JONeillSr/RFID_Access/hardware/RFID_Door_Controller/board_top.png

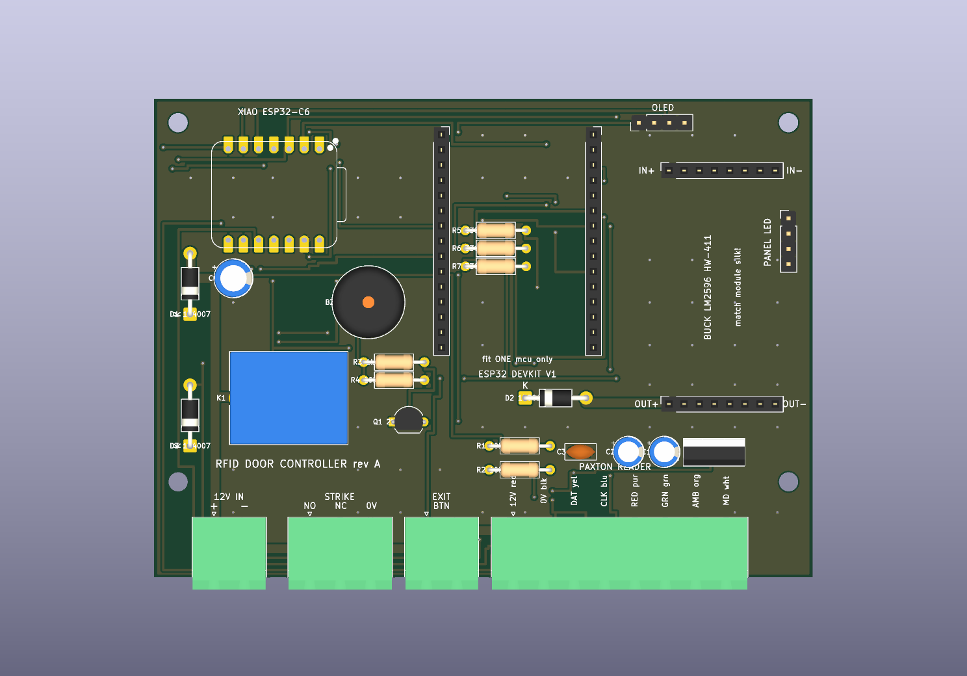
hardware/RFID_Door_Controller/board_top.png
