JONeillSr/RFID_Access/hardware/RFID_Door_Controller/RFID_Door_Controller.step

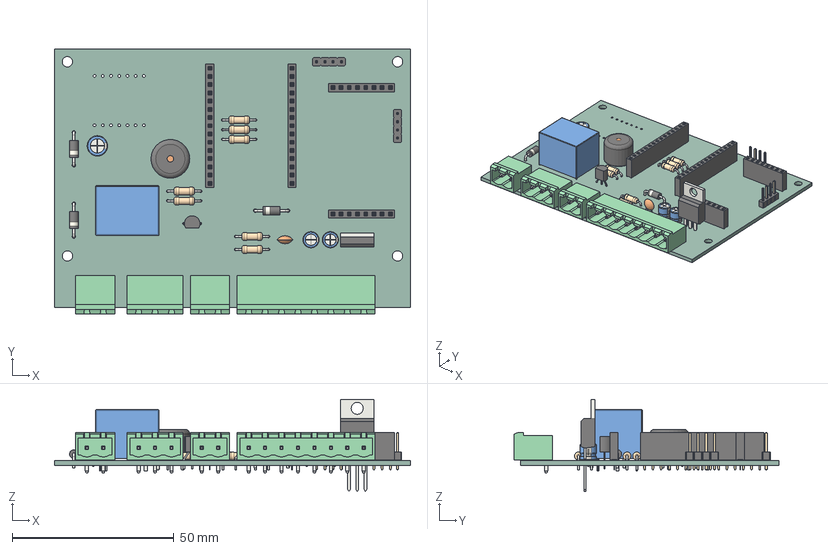
[picture p2: CAD file, 2026-08-13]
hardware/RFID_Door_Controller/RFID_Door_Controller.step
110.0 x 82.0 x 28.5 mm
PhoenixContact_MSTBA_2,5_2-G-5,08_1x02_P5.08mm_Horizontal x 2
PinSocket_1x08_P2.54mm_Vertical x 2
PinHeader_1x04_P2.54mm_Vertical x 2
R_Axial_DIN0207_L6.3mm_D2.5mm_P10.16mm_Horizontal x 7
D_DO-41_SOD81_P10.16mm_Horizontal x 3
PhoenixContact_MSTBA_2,5_8-G-5,08_1x08_P5.08mm_Horizontal
TO-220-3_Vertical
PhoenixContact_MSTBA_2,5_3-G-5,08_1x03_P5.08mm_Horizontal
CP_Radial_D6.3mm_P2.50mm
C_Disc_D5.0mm_W2.5mm_P2.50mm
TO-92_Inline_Wide
Buzzer_12x9.5RM7.6
Relay_SPDT_SANYOU_SRD_Series_Form_C
CP_Radial_D5.0mm_P2.50mm x 2
PinSocket_1x15_P2.54mm_Vertical x 2
RFID_Door_Controller_PCB
