JONeillSr/RFID_Access/hardware/RFID_Door_Controller/assembly_silk_guide.png

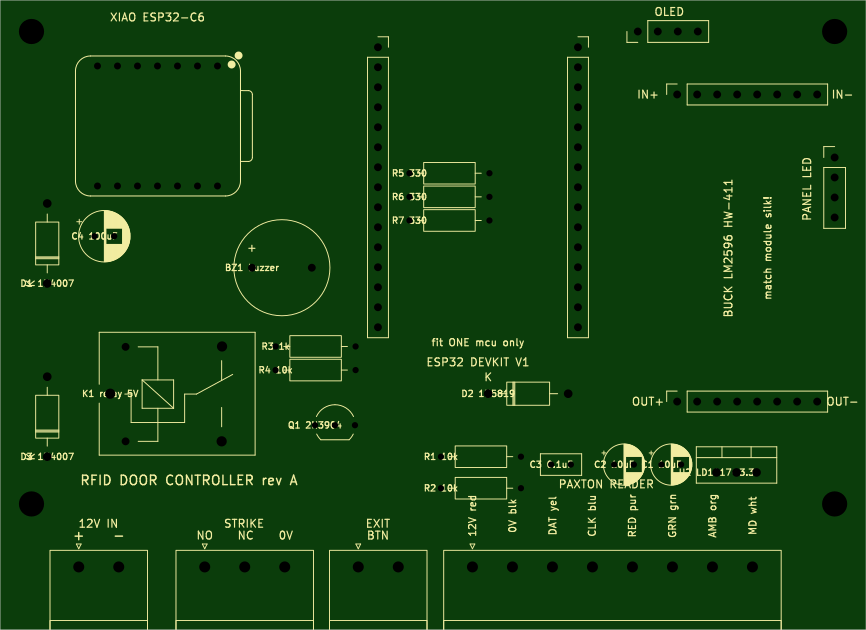
hardware/RFID_Door_Controller/assembly_silk_guide.png
