JONeillSr/RFID_Access/schematic.pdf

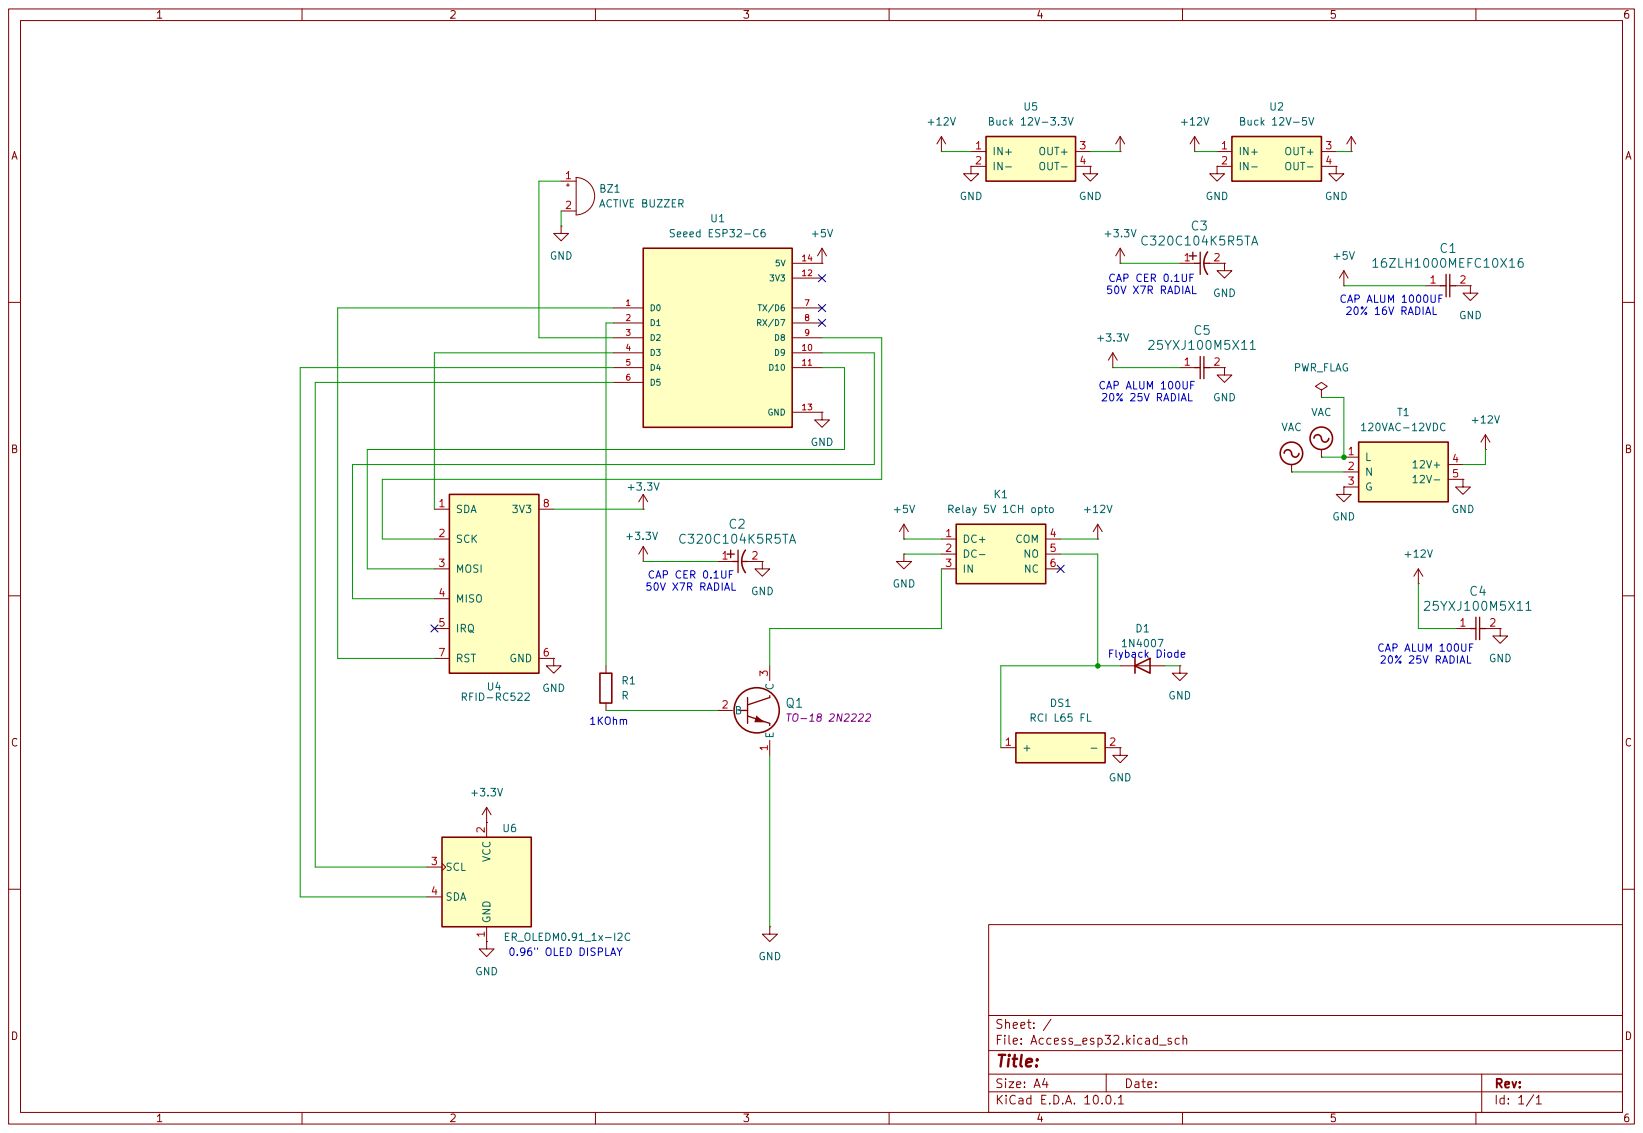
[picture p4: page 1]
