JONeillSr/RFID_Access/hardware/RFID_Door_Controller/RFID_Door_Controller.kicad_pcb

## KiCad design hardware/RFID_Door_Controller/RFID_Door_Controller.kicad_pcb (2026-08-13)

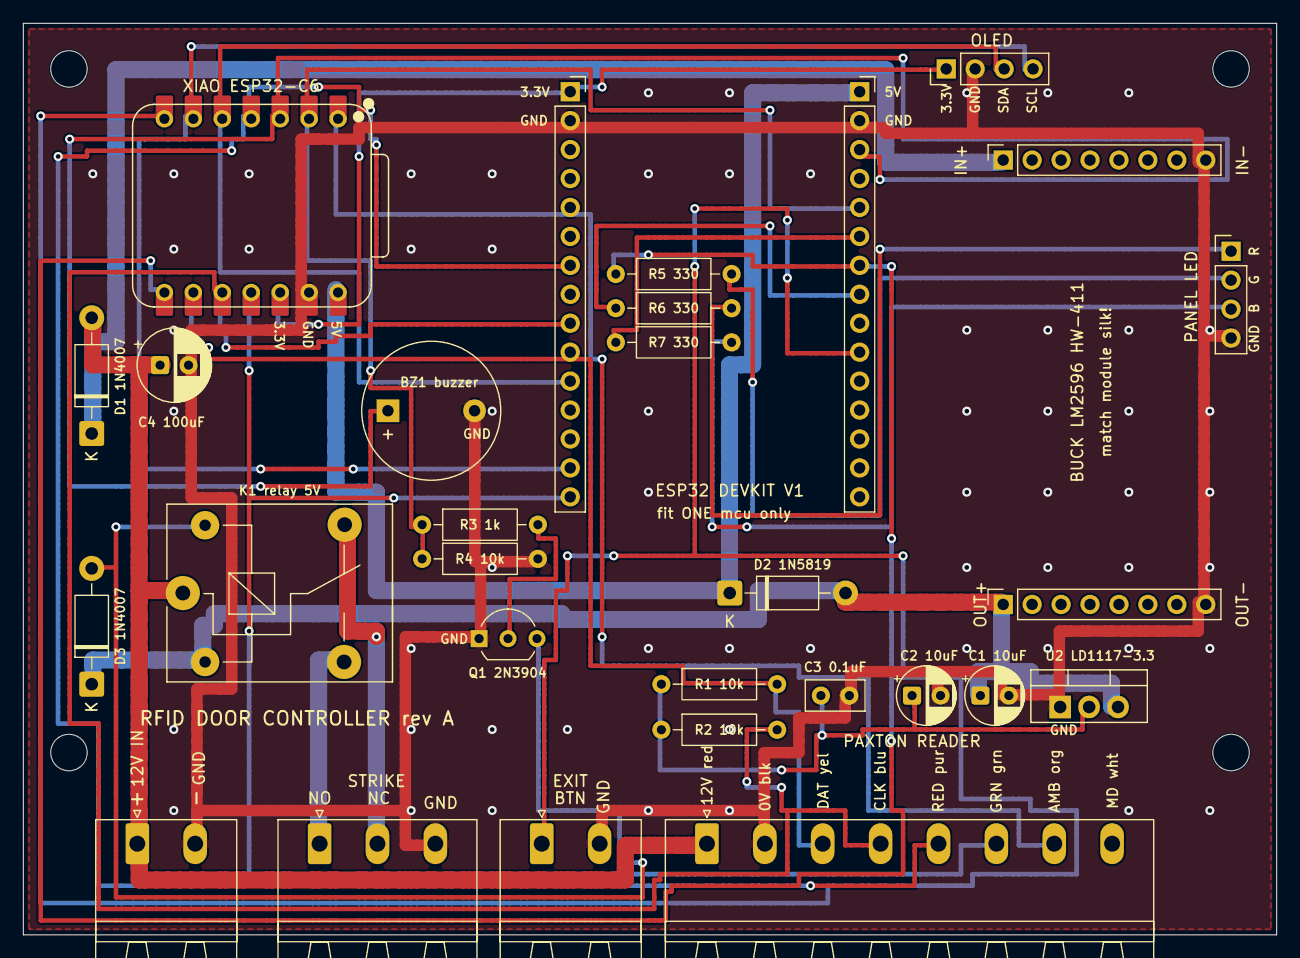
[picture p5: board RFID_Door_Controller.kicad_pcb from above]

Board: 2 copper layers, 110.0 x 80.0 mm, 33 parts (0 on the bottom side), 27 nets.

Parts:
BZ1: Buzzer_12x9.5RM7.6
C1, C2: 10u; CP_Radial_D5.0mm_P2.50mm
C3: 100n; C_Disc_D5.0mm_W2.5mm_P2.50mm
C4: 100u; CP_Radial_D6.3mm_P2.50mm
D1, D3: 1N4007; D_DO-41_SOD81_P10.16mm_Horizontal
D2: 1N5819; D_DO-41_SOD81_P10.16mm_Horizontal
H1, H2, H3, H4: MountingHole_3.2mm_M3
J1, J5: PhoenixContact_MSTBA_2,5_2-G-5,08_1x02_P5.08mm_Ho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; PhoenixContact_MSTBA_2,5_2-G-5,08_1x02_P5.08mm_Horizontal
J2, J10: PinSocket_1x08_P2.54mm_Vertical
J3: PhoenixContact_MSTBA_2,5_8-G-5,08_1x08_P5.08mm_Ho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; PhoenixContact_MSTBA_2,5_8-G-5,08_1x08_P5.08mm_Horizontal
J4: PhoenixContact_MSTBA_2,5_3-G-5,08_1x03_P5.08mm_Ho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; PhoenixContact_MSTBA_2,5_3-G-5,08_1x03_P5.08mm_Horizontal
J6, J7: PinHeader_1x04_P2.54mm_Vertical
J8, J9: PinSocket_1x15_P2.54mm_Vertical
K1: SRD-05VDC-SL-C; Relay_SPDT_SANYOU_SRD_Series_Form_C
Q1: 2N3904; TO-92_Inline_Wide
R1, R2, R4: 10k; R_Axial_DIN0207_L6.3mm_D2.5mm_P10.16mm_Horizontal
R3: 1k; R_Axial_DIN0207_L6.3mm_D2.5mm_P10.16mm_Horizontal
R5, R6, R7: 330; R_Axial_DIN0207_L6.3mm_D2.5mm_P10.16mm_Horizontal
U1: XIAO-ESP32-C6-DIP
U2: LD1117V33; TO-220-3_Vertical

Connections:
3V3_MCU: J6.1, J8.1, U1.12
3V3_PU: C2.1, C3.1, R1.1, R2.1, U2.2
5V: C1.1, D2.2, D3.1, J10.1, K1.2, U2.3
5V_MCU: D2.1, J9.1, U1.14
12V_PROT: D1.1, J2.1
12V_RAW: C4.1, D1.2, J1.1, J3.1, K1.1
AMBER_LED: J3.7, J8.5, U1.1
BUZZER: BZ1.1, J9.3, U1.3
CLOCK: J3.4, J8.9, R2.2, U1.10
COIL_SW: D3.2, K1.5, Q1.3
DATA: J3.3, J8.10, R1.2, U1.9
EXIT_BTN: J5.1, J9.10, U1.7
GND: BZ1.2, C1.2, C2.2, C3.2, C4.2, J1.2, J2.8, J3.2, J4.3, J5.2, J6.2, J7.4, J8.2, J9.2, J10.8, Q1.1, R4.2, U1.13, U2.1
GREEN_LED: J3.6, J8.15, U1.11
PANEL_B: J9.6, R7.1
PANEL_B_J: J7.3, R7.2
PANEL_G: J9.7, R5.1, U1.8
PANEL_G_J: J7.2, R5.2
PANEL_R: J9.8, R6.1
PANEL_R_J: J7.1, R6.2
Q1_B: Q1.2, R3.2
RED_LED: J3.5, J8.7, U1.4
RELAY_CTL: J9.5, R3.1, R4.1, U1.2
SCL: J6.4, J8.14, U1.6
SDA: J6.3, J8.11, U1.5
STRIKE_NC: J4.2, K1.4
STRIKE_NO: J4.1, K1.3
