JONeillSr/RFID_Access/src/JTLogoBitmap.h

#pragma once
#include <Arduino.h>

/**
 * @file    JTLogoBitmap.h
 * @brief   The JT Custom Trailers boot-logo bitmap (project-specific data).
 *
 * Kept separate from the generic SplashScreen library so the animator stays
 * logo-agnostic. Pass these to SplashScreen:
 *   SplashScreen splash(display, JT_LOGO, JT_LOGO_W, JT_LOGO_H, JT_LOGO_REST_Y);
 *
 * The bitmap is 1-bit, Adafruit_GFX drawBitmap format.
 */

static const uint16_t JT_LOGO_W = 128;
static const uint16_t JT_LOGO_H = 33;
// Rest near the top so it sits in the blue zone of a 2-color OLED (matches the
// original splash placement). Use -1 with SplashScreen for vertical centering.
static const int16_t  JT_LOGO_REST_Y = 17;

static const unsigned char JT_LOGO[] PROGMEM = {
  0x00, 0x00, 0x00, 0x00, 0x00, 0x00, 0x00, 0x00, 0x00, 0x00, 0x00, 0x00,
  0x00, 0x03, 0x83, 0xC0, 0x00, 0x00, 0x00, 0x00, 0x00, 0x00, 0x00, 0x00,
  0x00, 0x00, 0x00, 0x78, 0x7F, 0x0F, 0x87, 0xC0, 0x00, 0x00, 0x00, 0x00,
  0x00, 0x00, 0x00, 0x00, 0x1C, 0x3F, 0xBF, 0xF9, 0xFF, 0x9F, 0x8F, 0xC0,
  0x00, 0x00, 0x00, 0x00, 0x00, 0x00, 0x3F, 0x9E, 0x3C, 0xFF, 0xBF, 0xFB,
  0xFF, 0x9F, 0x8F, 0xC0, 0x00, 0x00, 0x00, 0x00, 0x00, 0x18, 0xFF, 0xBE,
  0x3D, 0xFF, 0x7F, 0xF7, 0xC7, 0xDF, 0xDF, 0x80, 0x00, 0x00, 0x00, 0x1F,
  0xFF, 0xF9, 0xFF, 0xBC, 0x3D, 0xE0, 0x07, 0x87, 0x87, 0xDF, 0xDF, 0x80,
  0x00, 0x07, 0xFF, 0xFF, 0xFF, 0xFB, 0xE0, 0x3C, 0x3D, 0xE0, 0x07, 0x0F,
  0x07, 0x9F, 0xFF, 0x80, 0x00, 0x0F, 0xFF, 0xFF, 0xFF, 0xF3, 0xC0, 0x3C,
  0x79, 0xFE, 0x0F, 0x0F, 0x07, 0xBD, 0xF7, 0x80, 0x00, 0x1F, 0xFF, 0xFF,
  0xFF, 0xF3, 0xC0, 0x7C, 0x79, 0xFF, 0x0F, 0x0F, 0x07, 0xBD, 0xF7, 0x80,
  0x00, 0x1F, 0xFF, 0xFF, 0xFF, 0xF7, 0x80, 0x7C, 0x78, 0x3F, 0x0F, 0x0F,
  0x0F, 0x3D, 0xE7, 0x00, 0x00, 0x1F, 0xFF, 0xFF, 0xFF, 0xE7, 0x80, 0x7C,
  0x78, 0x0F, 0x0F, 0x0F, 0xFE, 0x3C, 0xCF, 0x00, 0x00, 0x1F, 0xFF, 0xFF,
  0xFF, 0xE7, 0x80, 0x7C, 0xF3, 0xFF, 0x1E, 0x0F, 0xFC, 0x78, 0x0F, 0x00,
  0x00, 0x3F, 0xFF, 0xFF, 0xFC, 0x07, 0xFE, 0x7F, 0xF7, 0xFE, 0x1E, 0x07,
  0xF8, 0x78, 0x00, 0x00, 0x00, 0x3F, 0xFC, 0x0F, 0xF8, 0x03, 0xFE, 0x3F,
  0xE7, 0xFC, 0x1E, 0x00, 0x00, 0x00, 0x00, 0x3E, 0x00, 0x0F, 0xF8, 0x0F,
  0xF8, 0x01, 0xFE, 0x1F, 0x83, 0xE0, 0x00, 0x00, 0x00, 0x1F, 0xE0, 0xFF,
  0x00, 0x0F, 0xF8, 0x0F, 0xF8, 0x00, 0xF0, 0x00, 0x00, 0x00, 0x06, 0x01,
  0xFF, 0x3F, 0xF3, 0xFF, 0x00, 0x0F, 0xF0, 0x1F, 0xF0, 0x00, 0x00, 0x00,
  0x07, 0x03, 0xDF, 0x03, 0xFF, 0x3F, 0xFB, 0xE2, 0x00, 0x0F, 0xF0, 0x1F,
  0xF0, 0x3F, 0xE7, 0xFC, 0x0F, 0x83, 0x9E, 0x03, 0xFF, 0x3C, 0xFB, 0xC0,
  0x00, 0x1F, 0xF0, 0x1F, 0xF0, 0xFF, 0xEF, 0xFE, 0x1F, 0x87, 0x9E, 0x03,
  0xC0, 0x78, 0x7B, 0xF8, 0x00, 0x1F, 0xE0, 0x1F, 0xF0, 0xFF, 0xEF, 0xFE,
  0x1F, 0x87, 0x9E, 0x07, 0xFC, 0x78, 0xF3, 0xFE, 0x00, 0x1F, 0xE0, 0x3F,
  0xE0, 0xFF, 0x0F, 0x1E, 0x3F, 0x87, 0x9E, 0x07, 0xFC, 0x7F, 0xE1, 0xFE,
  0x00, 0x1F, 0xE0, 0x3F, 0xE0, 0x1E, 0x1E, 0x1E, 0x7B, 0x87, 0xBC, 0x07,
  0xFC, 0x7F, 0xC0, 0x1E, 0x00, 0x3F, 0xC0, 0x3F, 0xE0, 0x1E, 0x1F, 0xFC,
  0x73, 0xCF, 0x3C, 0x07, 0x80, 0xFF, 0xC0, 0x3E, 0x00, 0x3F, 0xC0, 0x7F,
  0xE0, 0x1C, 0x1F, 0xF8, 0xF7, 0xCF, 0x3C, 0x0F, 0x00, 0xF3, 0xC7, 0xFC,
  0x7C, 0x3F, 0xC0, 0x7F, 0xC0, 0x3C, 0x1F, 0xF0, 0xFF, 0xCF, 0x3F, 0xEF,
  0xFE, 0xF3, 0xCF, 0xF8, 0xFC, 0x7F, 0x80, 0x7F, 0xC0, 0x3C, 0x3F, 0xF1,
  0xFF, 0xCF, 0x7F, 0xEF, 0xFC, 0xF3, 0xE7, 0xE0, 0xFC, 0x7F, 0x80, 0x7F,
  0xC0, 0x3C, 0x3C, 0xF3, 0xE3, 0xDE, 0x7F, 0xEF, 0xFC, 0xE0, 0x00, 0x00,
  0xFF, 0xFF, 0x00, 0xFF, 0x80, 0x38, 0x3C, 0xFB, 0xC3, 0xDE, 0x7F, 0x00,
  0x00, 0x00, 0x00, 0x00, 0xFF, 0xFF, 0x00, 0xFF, 0x80, 0x78, 0x3C, 0x7F,
  0x80, 0x00, 0x00, 0x00, 0x00, 0x00, 0x00, 0x00, 0xFF, 0xFE, 0x00, 0xFF,
  0x80, 0x78, 0x00, 0x00, 0x00, 0x00, 0x00, 0x00, 0x00, 0x00, 0x00, 0x00,
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
};
