JONeillSr/RFID_Access/(commit log)

2026-08-13 Add board NVS backup
2026-08-15 Update to 2.1.0
    [partitions_rfid.csv]
2026-08-16 Fix packaging that deployed zero functions and took the fleet offline
    Compress-Archive produces a zip that is valid on Windows and unusable on the
    Linux Functions host, in two ways:
    - almost no directory entries -- 65 for this tree, and not the one holding
    the functions
    - external_attr = 0, i.e. Unix mode 000, so no file is readable
    Flex Consumption mounts the zip rather than extracting it, so both survive to
    runtime. A glob has to enumerate directories and stat files and can do neither:
    Worker was unable to load entry point "dist/api/src/functions/*.js":
    Found zero files matching the supplied pattern
    The host then registers zero functions and every route 404s -- includin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
2026-08-16 Roadmap: Phase 5 write side done, heap TODO, offline test log
    Phase 5 is now read and write. The on-device read-only lockout is the next
    piece: it was blocked on the write UI existing, since enforcing it earlier
    would have left paired doors unadministrable.
    Adds a TODO to expose free heap on /status, with minimum-free-since-boot.
    Found during the offline test: six hours of failed syncs are observable in
    every respect except the one that would reveal a leak, and repeated failed TLS
    handshakes are where a leak is most likely. The boot counter only catches a
    leak large enough to be fatal inside the window; a slower one looks like a
    healthy run and kills a door weeks later in the field. CloudSy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
2026-08-16 Require Admin to delete a credential
    The API allowed Operators to delete credentials while the documented role model
    and the admin UI both said Admin. The API was the permissive one, so the button
    being hidden was the only thing stopping it -- and hiding a button is a
    courtesy, not a control.
    Settled in favour of Admin, because deactivate and delete are not variations of
    the same action:
    deactivated future taps still name the holder -- "Carl - DENIED" at 2am
    deleted the same tap resolves to nobody, lands in the unknown-card feed,
    and is offered up for enrolment
    credentialIndex() resolves events against every credential regardless of
    `active`, which is what makes t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
2026-08-17 Pre-commit and commit-msg hooks: block card numbers
    The gitignore rules keep seed.json and *-fobs.json out of the repo and they work
    -- but they protect known FILES. A number pasted into source as a placeholder
    walks straight past them, into a public repo, in a file nobody would think to
    check. That is not hypothetical: a real enrolled card number was used as the
    placeholder in the fob form and reached a commit here earlier today.
    Two rules, calibrated against the whole tracked tree before shipping rather than
    tuned afterwards:
    A. a zero-padded run of 8-12 digits. Clock&Data cards are read digit-for-digit
    off the card and are conventionally padded; every legitimate long constant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
2026-08-17 Expose heap and retry schedule on /status
    Heap, with the LOW-WATER MARK since boot, which is the number that matters.
    Current free heap only describes the instant you looked, so a device that dipped
    to 4 KB during a TLS handshake an hour ago looks perfectly healthy now. The
    minimum survives the spike, so a unit can be interrogated after the fact rather
    than having to be caught in the act. Largest-free-block goes alongside it as the
    fragmentation check: a TLS context is a big allocation, and "80 KB free" is not
    reassuring when the biggest contiguous run is 6 KB.
    Also the current backoff interval and time to the next attempt, whenever a door
    is not on its normal poll. "Is this door backing of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
2026-08-17 Local roster and schedule go read-only once a door is paired
    /api/add, /api/rename, /api/remove and POST /api/schedule now answer 409 while
    the door is centrally managed. Read endpoints are untouched, so a door still
    explains itself locally when the network is gone.
    A controller that can enrol its own fobs while offline is an attack surface:
    anyone who reaches one door's page could add themselves, and the central
    database would not know until it silently overwrote the entry on the next sync.
    It also removes any possibility of local/central drift, since the roster then
    has exactly one writer.
    The accepted cost is that a fob cannot be enrolled during a WAN outage. Doors
    keep working from the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
    [main.cpp]
2026-08-17 Show when NTP last synced, not merely that it once did
    The status line said (NTP synced) for 21.7 hours during the offline test, while
    all outbound UDP -- NTP included -- was blocked. It meant 'has synced since
    boot', which is reassuring in exactly the situation where it should not be.
    The clock free-runs on the crystal between syncs, so a device whose NTP has been
    unreachable for a day still shows a plausible time and nothing says otherwise.
    'The time looks right' and 'the time is being maintained' are different claims,
    and only the first was visible.
    Now:
    Time: Mon 2026-08-17 01:47 PM (NTP synced 3m ago)
    Time: Mon 2026-08-17 01:47 PM (NTP unreachable for 21h - drifting)
    Time: Mo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
    [main.cpp]
2026-08-17 Release 2.6.0
    Paired doors go read-only locally; heap, retry schedule and NTP age on /status.
    Minor rather than patch because /api/add, /api/rename, /api/remove and POST
    /api/schedule now refuse with 409 while a door is paired. That is a behaviour
    change for anyone administering a door from its own page, and the version
    number should say so.
    Published for ESP32 DevKit V1 only -- the sole board in the fleet. The other
    three are built and warning-free but not published, matching the existing
    convention of publishing only what something is running: an OTA failure needs
    physical access to recover, so an untested image should not sit waiting for the
    first device of that board to pair.
    Front Do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
2026-08-17 docs: printable field guide for adding a new board type
    One page covering a new board from toolchain support through rollout, with the
    gate at each step and where mistakes stop being recoverable. Worked through with
    the ESP32-S31, which currently fails the first gate -- the installed platform
    has no board definition for it, so the guide records that as the state to
    re-check rather than assuming specifics about a part nobody here has run.
    Lives in the repo because the shared copy renders inside a frame, where the page
    box belongs to the host document and an orientation or margin request is
    silently dropped: the print CSS applies, the orientation does not, and the
    result is a wide layout runn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
2026-08-17 Backend host becomes runtime configuration
    CLOUD_HOST was a #define, so every image could only ever talk to one backend.
    With one deployment per customer -- each in their own tenant, each with its own
    Function App hostname -- that meant a firmware build per customer: the per-board
    OTA matrix multiplied by the customer count, version numbers that no longer
    identify anything on their own (2.6.0 for whom?), and images that stop being
    interchangeable in a way nothing detects. A spare flashed from the wrong folder
    boots perfectly and quietly syncs to somebody else's backend.
    The host now lives in DeviceSettings beside the device key, set on /setup.
    CLOUD_HOST_DEFAULT is only the value a door use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
    [main.cpp]
2026-08-17 Release 2.7.0
    Backend host is runtime configuration rather than a compile-time constant, so
    one image serves every customer. Changing it unpairs the door, since a device
    key is issued by the backend that minted it.
    Published for ESP32 DevKit V1. Front Door carries fwHold so this reaches Test
    Door 1 alone -- the pairing path is the part that needs proving on hardware, and
    proving it means deliberately breaking pairing on the door under test.
2026-08-18 Match the project's spelling: enroll, not enrol
    The dashboard button read Enrol... -- British spelling plus an ellipsis marking
    an action that opens a dialog. Together they read as clipped text, which is
    exactly how it was reported. A truncation marker only works when the word in
    front of it is obviously complete.
    The rest of the project is American throughout: the firmware /config page, the
    API, /api/v1/enroll, the seed tool. The admin UI I added was the odd one out,
    including in a file named EnrollDialog.jsx.
    Dropped the ellipsis rather than fixing it in place. The row has one action and
    the copy above already says clicking opens something, so the marker was doing no
    work worth the ambig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
2026-08-18 Firmware history report: what each door ran, and whether it came back
    GET /v1/admin/reports/firmware, fleet-wide or one door, joined to the Reports
    page as a mode rather than another filter -- it asks about the doors themselves
    rather than who went through them.
    The part worth building was not the event list. A door can report a successful
    flash and never start again, and a version number alone cannot tell you: the
    door simply stops checking in, which looks like a network problem. So each
    firmware event is matched to the next boot event after it, and a success with no
    boot behind it is reported as unconfirmed.
    updated 2.5.2>2.6.0 came back 2:18:06 PM proven
    updated 2.6.0>2.7.0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
2026-08-18 Derive the NTP staleness threshold from the SDK, and fix the age format
    The threshold was two hours, chosen on the assumption that ESP-IDF re-polls
    hourly. It does not. The installed framework sets
    CONFIG_LWIP_SNTP_UPDATE_DELAY 10800000 // 3 hours
    so a two-hour threshold reported "NTP unreachable - drifting" on every healthy
    door for a third of every cycle. A warning that fires on working hardware is
    worse than no warning: it teaches people to ignore the one that matters. Both
    doors were observed sitting at 87 minutes since last sync, which already
    falsified the assumption before the constant was found.
    It now derives from that constant rather than being another number picked by
    ha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
    [main.cpp]
2026-08-18 Fix roster writes failing on a fragmented heap, and the deadlock that hid it
    Both doors stopped applying roster changes while reporting themselves healthy:
    "roster write failed", ~130 KB free, every sync succeeding at the HTTP level.
    Access changes made in the admin app simply never reached the doors.
    Roster::replaceAll allocated a SECOND full-capacity array -- MAX_ENTRIES * 48 B
    = 24 KB contiguous -- and swapped it in. So applying a five-fob roster, 240
    bytes of actual data, demanded 24 KB of contiguous heap while the live array of
    the same size was still held, at the one moment the heap is most fragmented:
    called from the sync path with the TLS context (~45 KB) still allocated.
    Free heap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
2026-08-18 Report what is published and who would actually receive it
    The web equivalent of 'npm run publish-fw -- --list', reading the same
    listFirmware() helper so the page and the CLI cannot drift into disagreeing
    about what is published.
    A version on its own answers little, so each row carries who would receive it on
    their next check-in: up to date, will be offered, or held. A device is only ever
    offered the image published for its own board and refuses any other, and a held
    door is offered nothing -- so 'published' and 'will be delivered' are different
    claims and the report makes both visible.
    Two absences are called out, because neither appears in a list of published
    images:
    doors whose boar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
2026-08-18 docs: correct the NTP interval everywhere, record the roster failure
    Four gaps, one of which was actively wrong and written earlier the same day.
    The WiFiManager README told readers ESP-IDF re-polls hourly. It does not --
    CONFIG_LWIP_SNTP_UPDATE_DELAY is 10800000 ms, three hours -- and that assumption
    is exactly what produced a threshold that reported healthy doors as drifting.
    The same claim was still sitting in two code comments, including one in a shared
    library, where it would have misled the next reader precisely as it misled me.
    It now says to take the interval from the SDK constant, and to verify the ifdef
    resolved rather than trusting it.
    The API README now documents the guard that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
    [main.cpp]
2026-08-18 Revoke door access when an Entra account is disabled or deleted
    Closes the commonest access-control failure: someone leaves, HR disables the
    account, and the fob keeps working because nobody told the door system.
    Offboarding becomes a single action in the place it already happens.
    The delivery half already existed -- effectiveRoster() skips inactive people, so
    active=false reaches every door on its next sync with no device change. This
    only decides when to set it.
    MEMBERSHIP IS STATED, NOT INFERRED
    managedBy is explicit ('entra' or 'manual') rather than guessed from whether an
    object id is present. An absent id would conflate a contractor who correctly has
    no account with an employee some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
2026-08-18 docs: build the Graph grant body in PowerShell, not by hand-escaping
    Hand-escaped JSON through az rest is the fragile step in that sequence, and it
    fails as an opaque 'invalid request body' rather than anything pointing at the
    quoting. ConvertTo-Json removes the escaping entirely.
    Adds the verification call, and a note to check the role query returns exactly
    one id before the POST -- more than one line means the filter also matched a
    delegated role, and the assignment fails or grants the wrong thing.
2026-08-18 Look up Entra accounts by sign-in name, and run the sweep on demand
    TWO ENHANCEMENTS, BOTH ABOUT THE GAP BETWEEN THE MODEL AND THE MOMENT
    Lookup by UPN. The object id is what gets stored -- emails change with marriages
    and rebrands, object ids do not -- but nobody knows anyone's object id, and
    copying a GUID out of the portal is exactly the transcription step that produced
    a mistyped card number earlier in this system's life. Type the sign-in name, get
    the id, and the display name fills in when the field is still blank.
    The lookup also reports whether the account is currently enabled, because
    linking an ALREADY-disabled account is a real case -- recording someone who has
    already left -- an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
2026-09-16 Roadmap: record the Wi-Fi outage and the gaps it exposed
    Both doors dropped off Wi-Fi around Aug 30 and it went unnoticed for 17 days.
    Access kept working from cached rosters and no revocation was stranded (roster
    rev 18 on both sides). The backend was healthy and nothing was rejected -- sync
    requests simply stopped arriving, because the doors were not on the network.
    Front Door was found broadcasting the open RFID-Setup portal, identified by its
    BSSID being the device MAC plus one.
    The headline gap: there is no way to change a door's Wi-Fi once it is set. The
    portal opens only at boot and only when the saved network is unreachable,
    WiFiManager::clearCredentials() is never called, and /setu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
2026-09-17 Release 2.7.4: leave the setup portal when the saved network returns
    begin() gives the saved network 10 s and falls back to the portal. Nothing ever
    tried again: loop() returned immediately in portal mode, so a door that booted
    during a brief outage stayed in the portal until someone rejoined it with the
    credentials it already had. Both doors spent 17 days that way.
    While the portal is up and credentials are saved, the door now:
    - gives the saved network a 15 s attempt every 60 s, stopping the STA side in
    between so the portal keeps its radio;
    - reboots on joining by any route, including the connect begin() started;
    - waits 60 s instead of 10 s on the boot after that recovery, carried in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
    [main.cpp]
2026-09-17 Roadmap: correct the outage cause; record the portal trap and timestamp repair
    The doors were rejoined to the same network with the same credentials, which
    rules out WPA3 or a router change rather than confirming either. Records the
    mechanism that actually held them offline (a boot during an outage, and a portal
    that never retried), the evidence pointing at power loss as the trigger, the
    future-dated events it exposed, and the repair with its verification.
2026-09-17 Release 2.8.0: detect forced and held-open doors on a door contact
    Without a contact the firmware knows the relay fired, not that the door opened.
    An optional reed contact on the frame now reports:
    - Door forced: the door opens with no grant or exit press within the relay hold
    plus 2 s, and no unlock window open. Asks for an immediate sync, at most once
    a minute.
    - Door held open: open past a limit (default 60 s) since the last release
    ended, and again with the total time once it closes.
    A door already open at boot is never "forced", since no opening was seen.
    Readings are debounced.
    The decisions live in lib/DoorContact, a small state machine with no hardware
    in it; main.cpp feeds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
2026-09-17 Show forced and held-open doors in the admin app
    - DoorForced (8) and DoorHeld (9) join EventType, with reasons NoRelease,
    HeldOpen and Closed. Both are personless, so they are filed under the door
    only and never reach the unknown-card enrolment feed.
    - The dashboard gets a forced-openings tile for the last 7 days and a list of
    each forced opening, taken from the whole window rather than the 12 most
    recent events, so a busy door cannot push one out of sight.
    - Labels for the new events; config events show their detail, so switching a
    door contact off is visible in the door's history.
    - The Person column shows the detail field only for card taps. Firmware,
    config and door events c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
2026-09-17 Roadmap: Phase 6 status, and PCB rev 2 requirements
    Phase 6 corrected and brought up to date: the doors in service are DevKit V1
    boards with spare inputs, unlock windows count as a release, free mechanical
    egress needs a request-to-exit input before "forced" can be trusted, and an
    offline door still cannot raise the alarm. Records what is deployed and what is
    verified.
    Adds the PCB rev 2 section: reconcile the hand edits into the generator first,
    pin every connector to its mating part (two of them damage a part if seated
    straight on rev A), and break out a door-contact terminal.
2026-09-18 Release 2.8.1: reader format per door, and apply the cloud door config
    The reader line format was a constructor argument, so a Wiegand site needed its
    own build of an image that is otherwise identical for every customer. It is now
    a per-door setting (NVS readerMode), applied in setup() before paxton.begin()
    because the format decides which capture interrupts attach. A change is saved
    at once, applied at the next boot, shown as pending until then on /setup and
    /status, and written to the spool as a config event -- picking the wrong format
    denies every fob at that door, and /setup has no login.
    FIX: the door now applies the config the backend has been sending all along.
    Relay hold, result-scr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
    [main.cpp]
2026-09-18 Roadmap: the reader format is cloud-owned; record the ignored-config gap
    Phase 8 step 1 updated: the format lives in the cloud door config while a door
    is paired, with /setup read-only there, and the open question about where it
    belongs is settled. Records that the backend had been pushing door config no
    device ever read, and the round trip still to prove on hardware.
2026-09-18 Keep marketing material out of the repository
    docs/marketing/ holds drafts, pricing and customer-facing collateral. Both repos
    are public, so it stays local.
2026-09-20 Move a door to another network without being able to strand it
    A door that was still connected could not be moved to a new network at all: the
    portal appears only at boot, and only when the saved network cannot be joined.
    A router swap or an SSID change meant a visit to every door, some above
    ceilings. Three ways now, in the order to reach for them.
    changeNetwork() tries new credentials and keeps them only once the door has an
    address; otherwise the ones that worked are written back and reconnected. A typo
    costs a reconnect, not a ladder. It runs as a state machine from loop() rather
    than blocking: switching networks drops the connection the request arrived on,
    so the web handler has to ans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
    [main.cpp]
2026-09-20 Set the door contact and arm the setup network from the admin app
    The reed contact was enabled only on the door's own setup page, which for a
    paired door is the one place the admin app says not to make changes. It is now
    part of the door config: doorContact and doorHeldSec, validated on the way in
    like the rest.
    A board with no free input reports hasDoorContact false and ignores both. The
    dialog disables the control there rather than offering a setting the door will
    drop, and warns before enabling one that is not wired yet -- an unconnected
    input reads as an open door, so the first thing you would see is a forced-open
    alert that is not real.
    openSetupPortal asks a door to raise its setup A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
2026-09-20 Roadmap: the Wi-Fi change gap is closed; record what is still open
    Marks the "no way to change a door's Wi-Fi" section fixed in 2.8.2 and answers
    it against the three requirements it originally set. Two are met. The third is
    not: /setup still has no login, so someone on the LAN can move a door to a
    network they control -- the same unauthenticated-local-surface gap tracked
    below, now with more reach.
    Also records that the AP-alongside-STA path is unproven on hardware: it assumes
    switching to WIFI_AP_STA does not drop a live station link, and that one
    listener on port 80 answers on both interfaces.
2026-09-21 Release 2.8.3: one writer for the door contact, and safe optional pins
    The reader format was read-only on /setup while a door is paired; the door
    contact was not. Both places could write it and the cloud silently won at the
    next sync, so a change made at the door looked applied and then undid itself
    minutes later with nothing said. The contact and its held-open limit now follow
    the same rule: shown read-only while paired, and refused in the save handler
    too, since /setup has no login and a disabled control is only HTML.
    Pins.h now defaults PIN_EXIT_BTN and PIN_DOOR_CONTACT to absent. A board section
    that omitted them did not get "no contact fitted": an undefined name evaluates
    to 0 in #if,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
2026-09-21 Docs: close the gaps an audit found, and fix the board bring-up guide
    README: lib/DoorContact was missing from the source tree entirely; EventLog's
    event list predated config and door forced/held; the /setup and /status rows
    predated the reader format, the WiFi fields and the contact line; and the
    contact was still described as enabled only at the door.
    ROADMAP: Phase 6 still said detection was unverified. Records the 2026-09-19
    bench test on Test Door 1 with its event timeline -- forced, held at exactly the
    configured 30 s, closed reporting 72 s against 73 s of wall clock, and nothing
    filed into the person tables. Also records what it did NOT prove: a legitimate
    opening staying silent, and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
2026-10-31 Show the relay hold on /status
    The relay hold and the result screen hold can both be set from the admin app,
    and neither appeared anywhere on the door, so there was no way to tell at the
    door what a grant would actually do. /status now has a Relay line.
    It shows the live values, not the stored ones: what the next grant will use,
    whether it came from the default or the cloud.
2026-10-31 Release 2.9.0: restart a door from the admin app
    The reader format and the setup network both wait for the door's next restart,
    and the only way to restart a door was to be standing next to it. The Doors
    page now has a Restart button (Admin, paired doors only).
    It is one-shot by id, not by flag. The button stamps the door row with a fresh
    request id, sync hands that id down, and the door stores it in NVS before it
    restarts and reports it on every sync after. The backend clears the request
    when the ids match, and a door ignores an id it has already honoured, so a
    response re-sent before the backend hears back cannot restart it twice.
    A request lapses after 15 minutes. A door that was offlin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
2026-10-31 Drop enrolled cards from "unknown cards seen"
    The list was built from denied taps alone. Those taps stay filed as unknown --
    the card was not enrolled when it tapped, and history should say so -- but the
    list is "cards to enrol", and a card enrolled since stayed on it with its Enroll
    button for as long as its old taps were inside the window.
    A card whose number is already a credential is now left off, the same test the
    enrol dialog uses for "already enrolled". The tap history is unchanged.
2026-10-31 Release 2.10.0: release a door from the admin app
    For a visitor at the door or someone without their fob. Operators and up get a
    Release button on the Doors page for any door on 2.10.0 that is checking in. The
    door unlocks for its usual relay hold, armed like a fob grant, and logs a
    RemoteRelease event that history shows as "released remotely by <name>".
    Speed decided the design. Sync runs every 30 s plus jitter, too slow for someone
    waiting outside. Long-poll would answer in a second but holds a Function
    execution open around the clock; Flex bills the instance's 2 GB for every second
    of that, about $130 a month for one button. So each door polls its own blob,
    release/<deviceId>, every 3 s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
2026-10-31 Widen the admin app and document release, restart and newer-only firmware
    The page was capped at 1150 px, so on a wide screen the doors table squeezed
    its columns and wrapped the row buttons onto two lines. The cap is now
    1600 px and row buttons stay on one line.
    README gains Remote release and Remote restart, the newer-only firmware
    offer, and the Relay: and Remote: lines on /status. ROADMAP drops the
    outdated rule that publishing an older version pulls the fleet back.
2026-10-31 Release 2.10.1: set the relay hold on /setup
    /setup gains a Relay section with the relay hold and result-screen hold.
    Like the reader format and door contact, it is read-only while the door is
    paired (the admin app owns it) and editable on an unpaired door, where a
    relay-hold change is logged as a config event. The clamping bounds are
    shared with the cloud config path so both enforce the same limits.
2026-10-31 Show the Doors page as cards on a phone
    Table gains an opt-in `cards` mode: below 720 px each row becomes a card with
    the first cell as its title, the other cells labelled by their header, and an
    unheaded last cell (row actions) along the bottom with thumb-sized buttons.
    Doors uses it. On phones the header drops the email and subtitle so the
    company name and Sign out fit, and the nav scrolls sideways. Desktop is
    unchanged.
2026-10-31 Show People, Groups and Dashboard as cards on a phone
    Turns on the Table `cards` mode for the People and Groups lists and the
    Dashboard's forced-door, unknown-card and recent-activity tables. A row with
    no actions (a viewer without write access) no longer leaves an empty button
    strip on its card.
2026-10-31 Show Reports as cards on a phone
    Turns on the Table `cards` mode for all four report tables (access events,
    published images, door firmware state, firmware changes), and stacks the
    report filters full width on a phone so each is an easy tap target.
2026-11-03 Release 2.12.0: a door's status in the admin app
    Each sync now carries the door's /status text and local IP. The backend stores
    them on the Doors row the sync writes anyway (no extra transaction), capped at
    STATUS_TEXT_MAX, and GET /v1/admin/doors/status (Viewer) returns them. The
    Doors page gains a Status button showing the text read-only, when it was
    reported, and the local IP with a link to the live page for someone on the
    door's network.
    Firmware: WebService exposes statusText(); CloudSync gains setStatusSource()
    and sends status and ip each sync, called outside its lock. FW_VERSION 2.12.0,
    skipping 2.11 so firmware matches the repo release numbers again.
    The API README's endpoint tabl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
2026-11-03 Release 2.12.1: say where in the admin app each setting lives
    A paired door's local pages said its fobs, schedule and settings were set in
    the admin app without saying where, and the admin app had no schedule
    control until the previous commit. They now name the place: fobs under
    People, the unlock schedule and the reader, relay and door-contact settings
    under Doors -> Edit, and an unknown card under Dashboard -> Unknown cards
    seen -> Enroll.
2026-11-03 Release 2.12.2: recover from a fragmented heap
    On 2.12.0 Front Door's heap fragmented within half an hour: 118 KB free but
    a 35 KB largest block, every sync failing while opening the connection, the
    release feed off for want of a 40 KB block, and the free-heap check blind to
    all of it. Test Door 1 on the same build was unaffected.
    - The status text goes up at most every 5 minutes, and only while the largest
    block is at least SYNC_MIN_BLOCK (45 KB). It is built into a buffer reserved
    up front, and the sync body is sized once, so neither leaves a trail of
    holes from regrowing.
    - A failed connection's error names the largest block measured just before
    it, so the threshold that actually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
2026-11-03 Release 2.12.3: say on /status when the release feed holds the heap
    The release feed keeps a TLS session open between syncs, about 55 KB, and
    closes it before each sync. A /status read while it was open showed free heap
    and the largest block well down, which looked like the fragmentation 2.12.2
    was built to recover from, when it was only the feed.
    WebService gains setHeapNote(), a line shown under Heap when the project has
    something to say. CloudSync gains feedOpen() and feedHeldBytes(), the latter
    measured as the heap the session took once its first poll is done. main
    wires the two: "(release feed connection open, holding ~55 KB; freed before
    each sync)". The README explains which reading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
2026-11-03 Release 2.12.4: Wi-Fi signal, channel and access point on /status
    Front Door alone showed slow pages, failed syncs, a failed update download
    and a fragmented heap, while Test Door 1 on the same build showed none. A
    weak link explains all of them, but nothing reported it.
    /status gains a Signal line under WiFi: RSSI with a rating (strong, good,
    fair, WEAK below -75 dBm, VERY WEAK below -80), the channel, and the access
    point's BSSID, since one SSID is often served by several. The admin app's
    Status button carries it with no web change.
2026-11-03 Release 2.12.5: keep the Wi-Fi radio awake
    The ESP32 defaults to modem sleep, dozing between beacons, so every exchange
    waits for the next one. That suits a battery, not a door on mains power: on
    Front Door's -75 dBm link the local /status page was slow and the release
    feed's reads timed out (error -11).
    WiFiManager switches modem sleep off after each mode change (station, the
    provisioning portal, and opening and closing the setup AP), since the core
    may reset it there. About 100 mA more on average, which mains power does not
    notice. It makes a marginal link more tolerant; it does not fix one.
